Bombsurace/Tabletop-Stadium-Scoreboard/frame/stl/endzone_left_letters.step

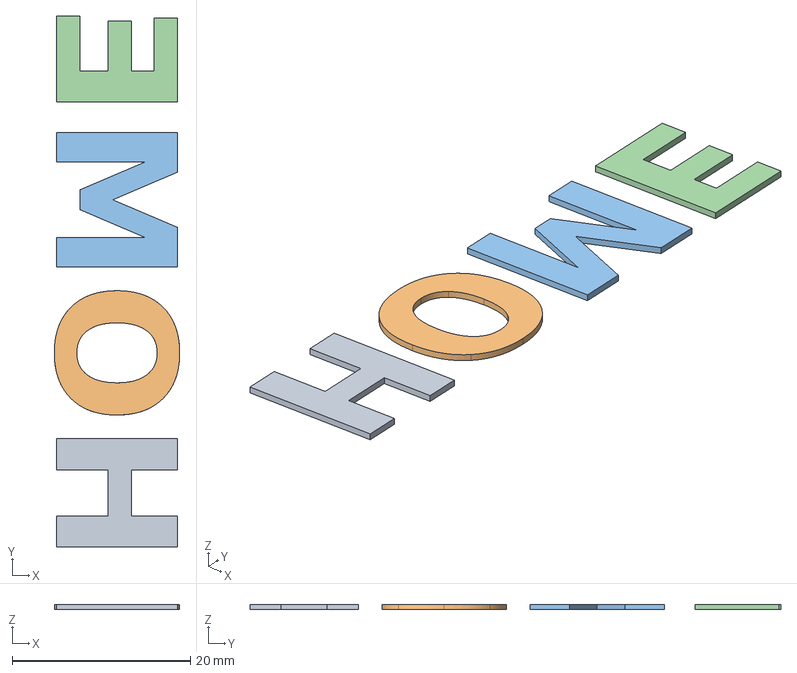
[picture p21: CAD file, 2026-11-06]
frame/stl/endzone_left_letters.step
14.1 x 59.5 x 0.6 mm
