Bombsurace/Tabletop-Stadium-Scoreboard/frame/stl/tests/kickstand_test_tight_catch.stl

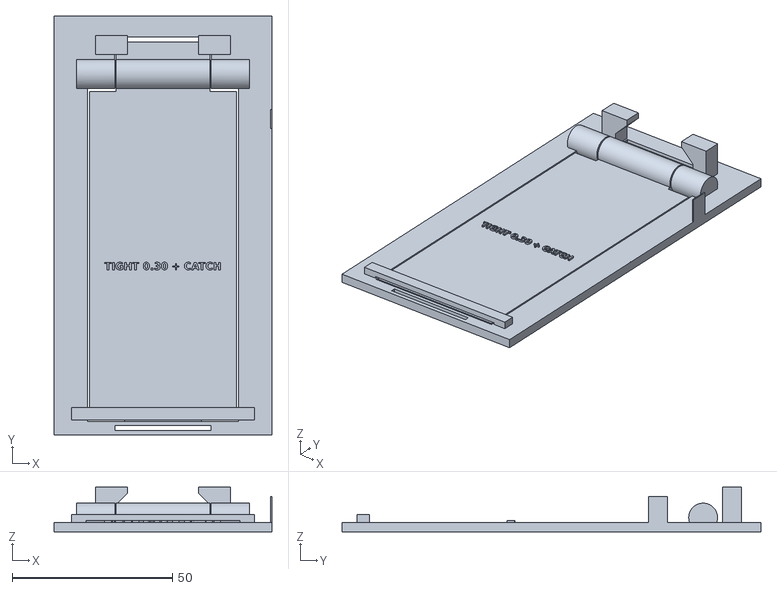
[picture p22: CAD file, 2026-11-05]
frame/stl/tests/kickstand_test_tight_catch.stl
68.0 x 130.6 x 14.0
