Bombsurace/Tabletop-Stadium-Scoreboard/frame/stl/endzone_left_2color.3mf

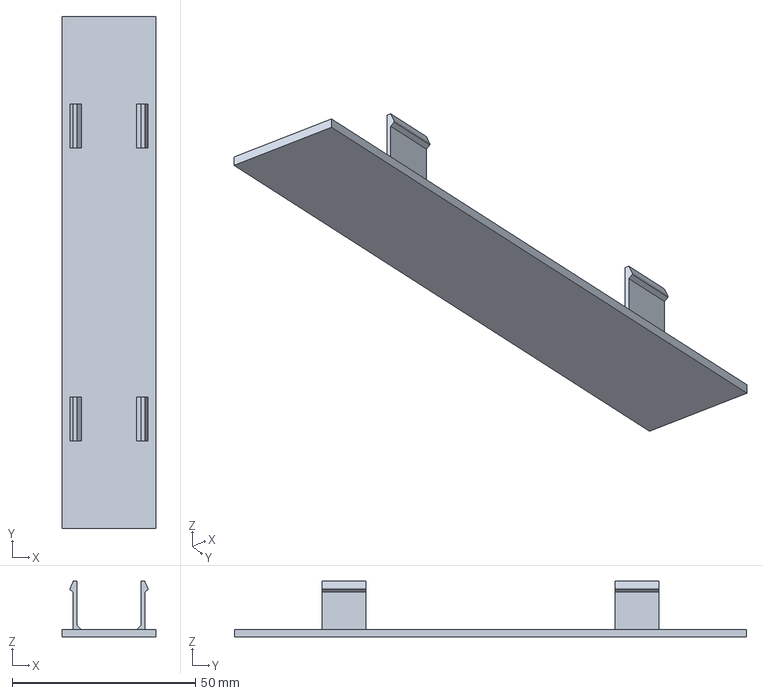
[picture p23: CAD file, 2026-11-06]
frame/stl/endzone_left_2color.3mf
25.6 x 139.6 x 15.2 mm
