Bombsurace/Tabletop-Stadium-Scoreboard/frame/stl/tests/hinge_test_tight.stl

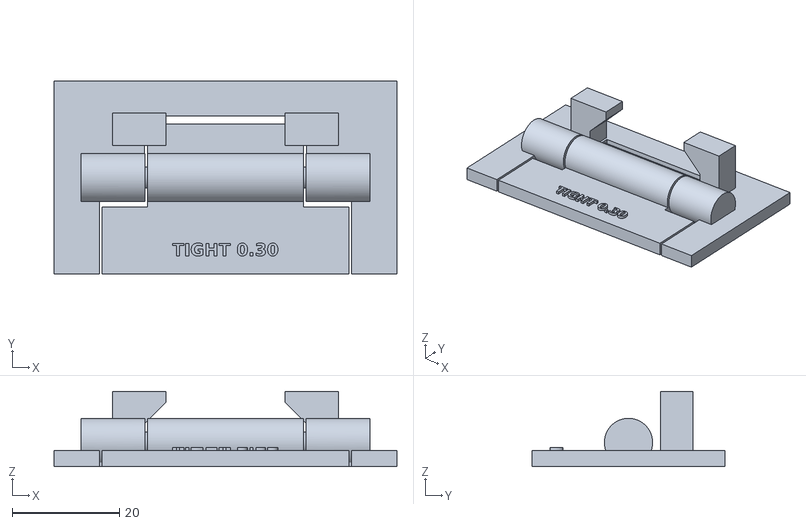
[picture p24: CAD file, 2026-11-05]
frame/stl/tests/hinge_test_tight.stl
64.0 x 36.0 x 14.0
