Bombsurace/Tabletop-Stadium-Scoreboard/frame/stl/endzone_right_letters.step

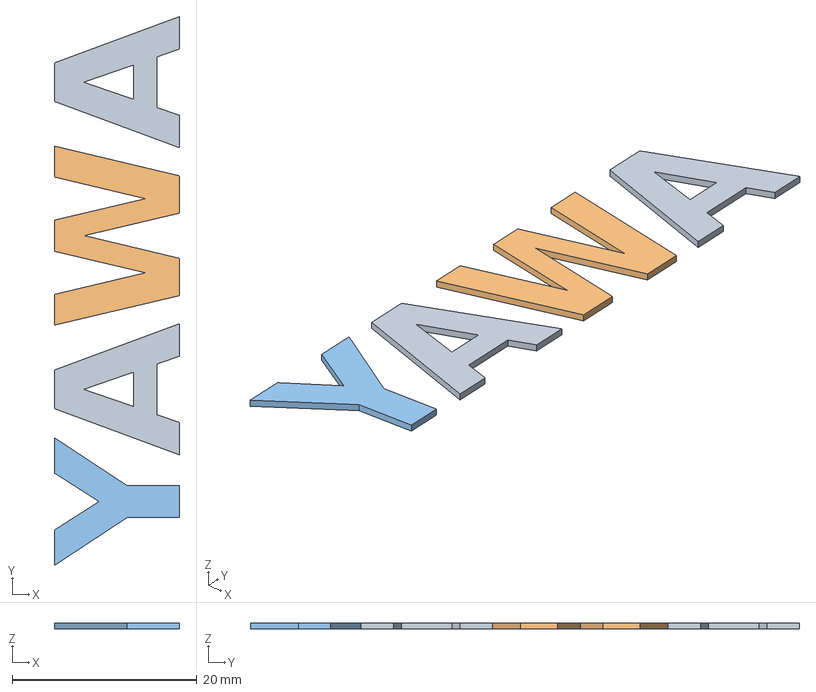
[picture p25: CAD file, 2026-11-06]
frame/stl/endzone_right_letters.step
13.6 x 59.4 x 0.6 mm
