Bombsurace/Tabletop-Stadium-Scoreboard/frame/stl/tests/screen_center_test_7in.stl

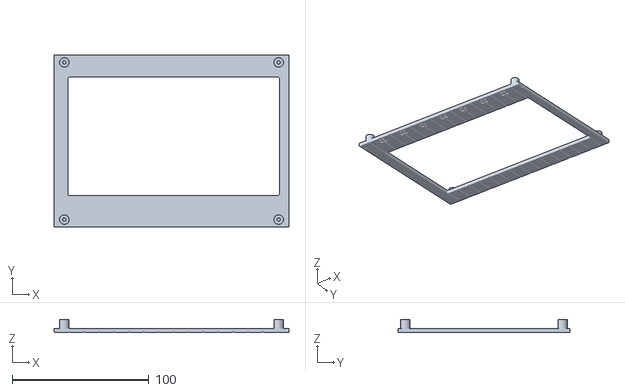
[picture p26: CAD file, 2026-11-05]
frame/stl/tests/screen_center_test_7in.stl
172.0 x 126.0 x 9.80
