Bombsurace/Tabletop-Stadium-Scoreboard/frame/stl/endzone_right.step

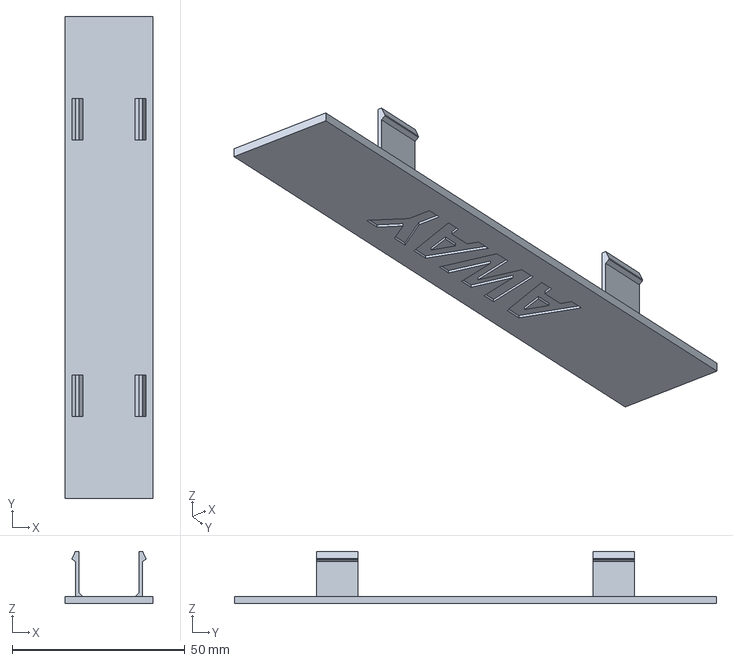
[picture p27: CAD file, 2026-11-06]
frame/stl/endzone_right.step
25.6 x 139.6 x 15.2 mm
