Bombsurace/Tabletop-Stadium-Scoreboard/frame/stl/tests/wall_fit_test_switch_usbc.stl

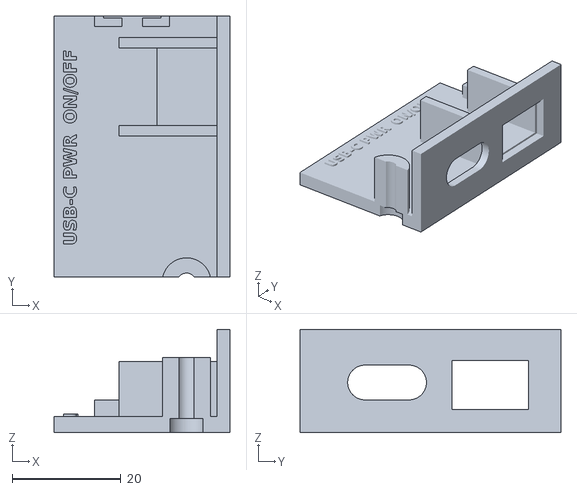
[picture p28: CAD file, 2026-11-05]
frame/stl/tests/wall_fit_test_switch_usbc.stl
32.4 x 48.0 x 19.0
