Bombsurace/Tabletop-Stadium-Scoreboard/frame/stl/tests/pi_antenna_fit_test.stl

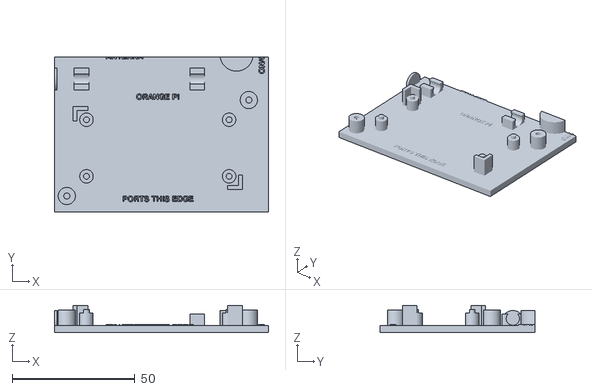
[picture p29: CAD file, 2026-11-05]
frame/stl/tests/pi_antenna_fit_test.stl
87.0 x 63.0 x 11.1
