Bombsurace/Tabletop-Stadium-Scoreboard/frame/stl/front_wide79_2color.3mf

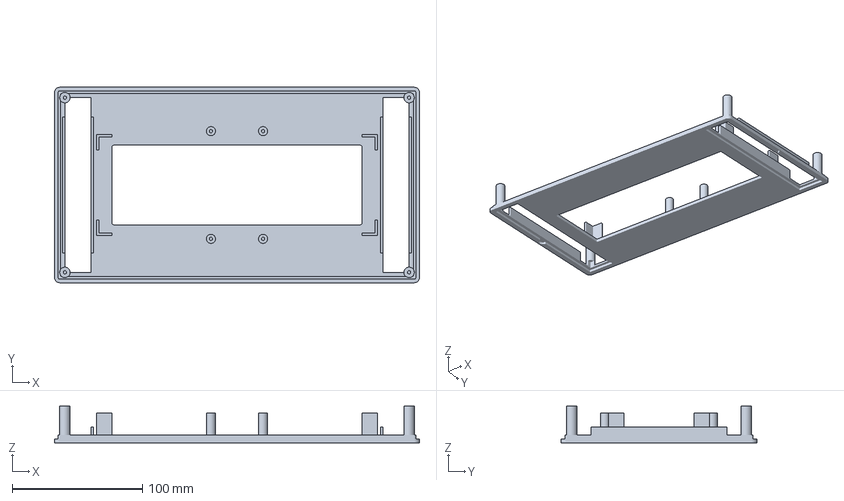
[picture p30: CAD file, 2026-11-05]
frame/stl/front_wide79_2color.3mf
280.0 x 150.0 x 28.0 mm
