Bombsurace/Tabletop-Stadium-Scoreboard/frame/stl/cutter_usb_c_socket.step

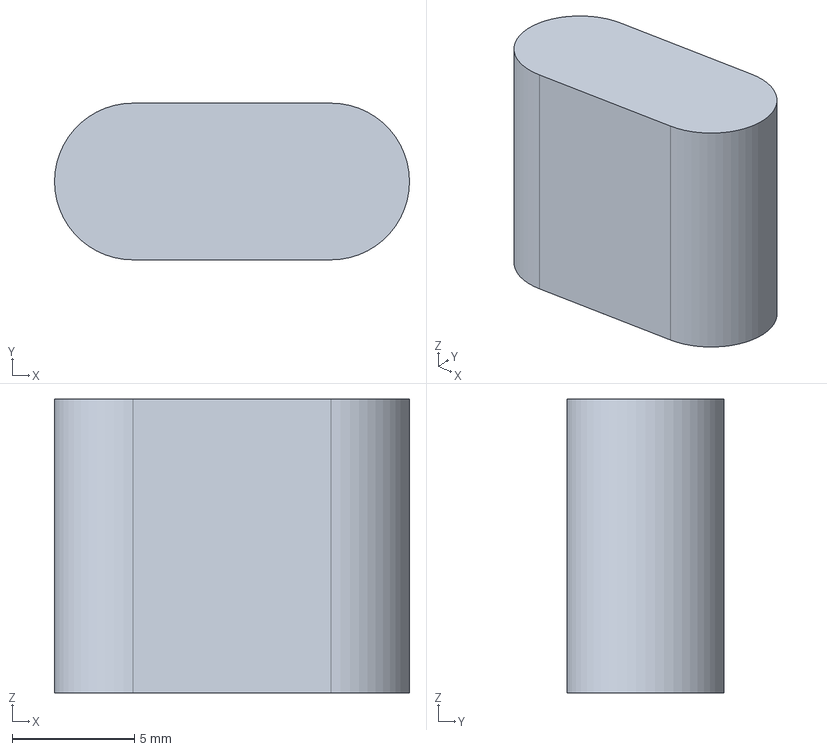
[picture p31: CAD file, 2026-11-05]
frame/stl/cutter_usb_c_socket.step
14.5 x 6.40 x 12.0 mm
