Bombsurace/Tabletop-Stadium-Scoreboard/frame/stl/back_tray_blank.step

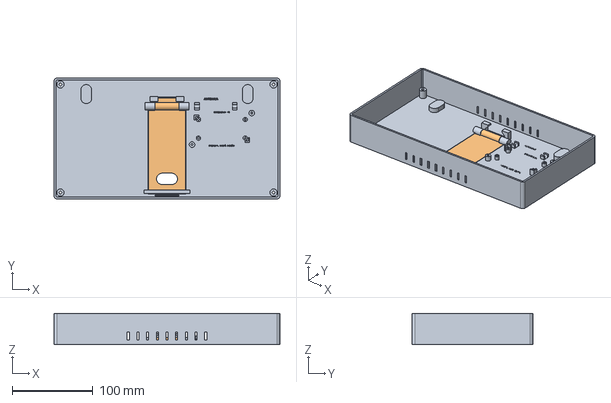
[picture p32: CAD file, 2026-11-05]
frame/stl/back_tray_blank.step
280.0 x 150.0 x 39.0 mm
