Bombsurace/Tabletop-Stadium-Scoreboard/frame/stl/endzone_blank.step

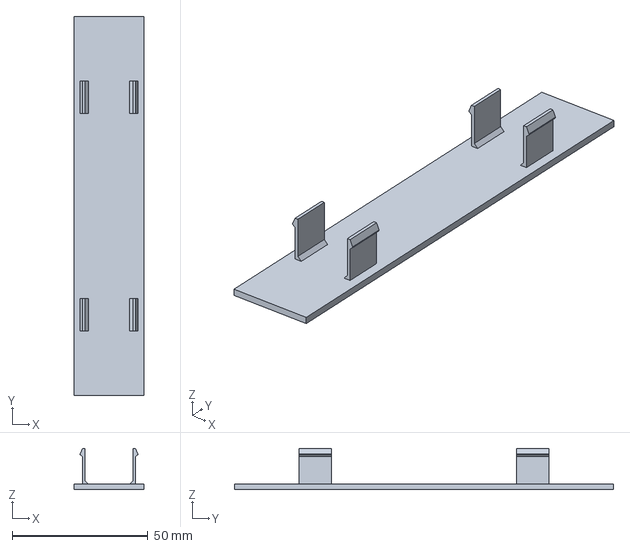
[picture p33: CAD file, 2026-11-05]
frame/stl/endzone_blank.step
25.6 x 139.6 x 15.2 mm
