Bombsurace/Tabletop-Stadium-Scoreboard/frame/stl/front_standard7_2color.3mf

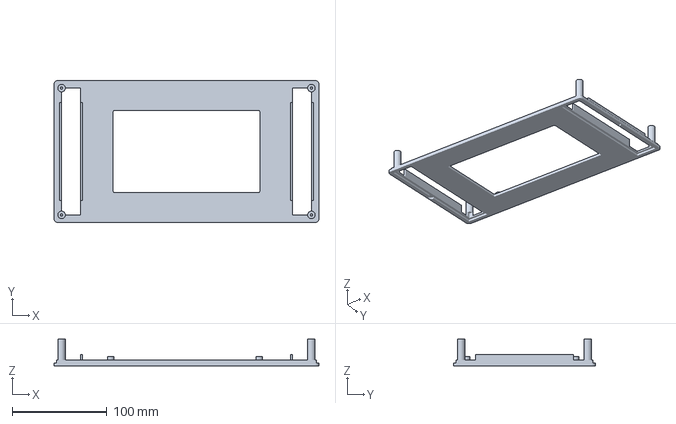
[picture p34: CAD file, 2026-11-05]
frame/stl/front_standard7_2color.3mf
280.0 x 150.0 x 28.0 mm
