Bombsurace/Tabletop-Stadium-Scoreboard/frame/stl/front_standard7.step

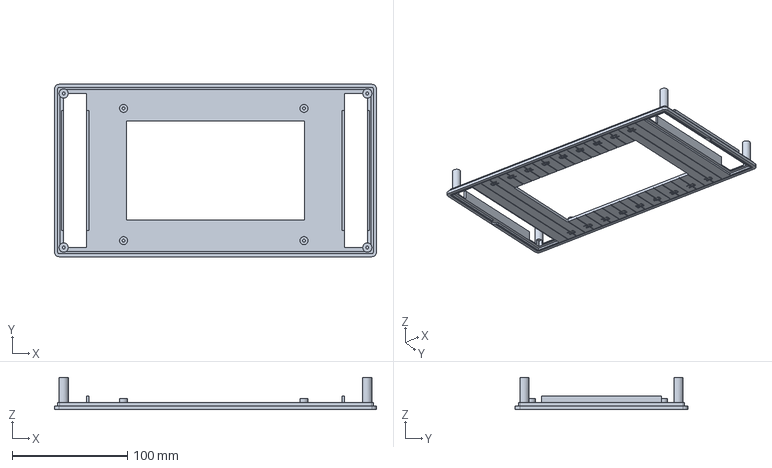
[picture p35: CAD file, 2026-11-05]
frame/stl/front_standard7.step
280.0 x 150.0 x 28.0 mm
