Bombsurace/Tabletop-Stadium-Scoreboard/frame/stl/front_standard7_lines.step

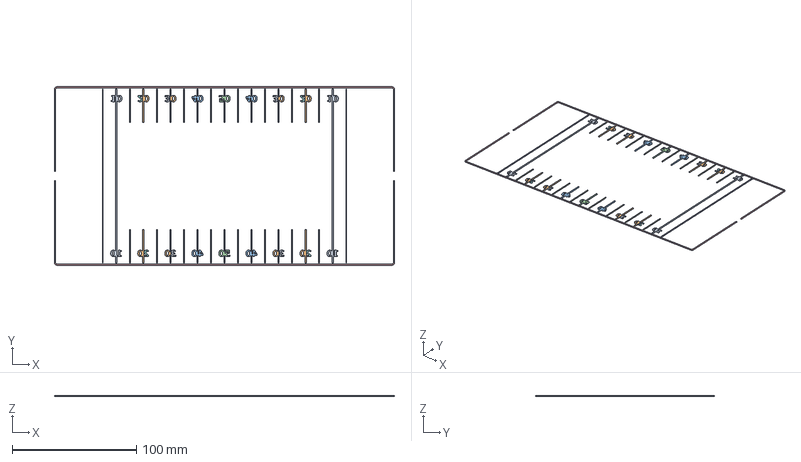
[picture p36: CAD file, 2026-11-05]
frame/stl/front_standard7_lines.step
274.0 x 144.0 x 0.6 mm
