Bombsurace/Tabletop-Stadium-Scoreboard/frame/stl/cutter_switch.step

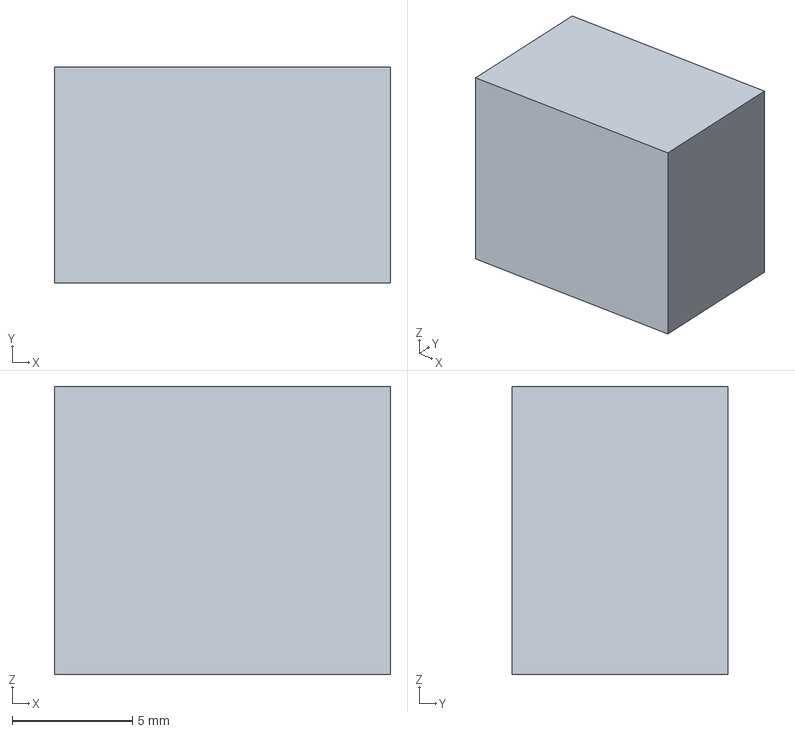
[picture p37: CAD file, 2026-11-05]
frame/stl/cutter_switch.step
14.0 x 9.00 x 12.0 mm
