Bombsurace/Tabletop-Stadium-Scoreboard/frame/stl/screen_tab.step

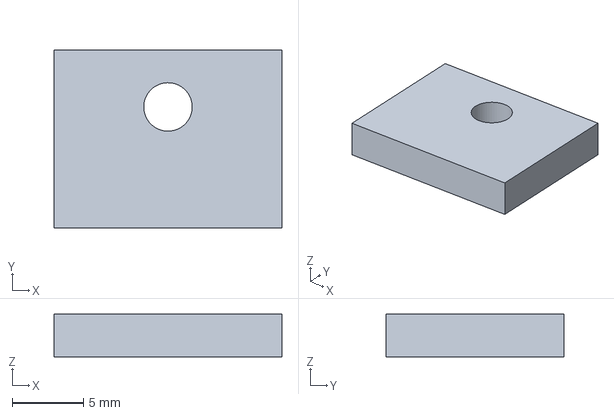
[picture p38: CAD file, 2026-11-05]
frame/stl/screen_tab.step
16.0 x 12.5 x 3.00 mm
