Bombsurace/Tabletop-Stadium-Scoreboard/frame/stl/pi_clamp.step

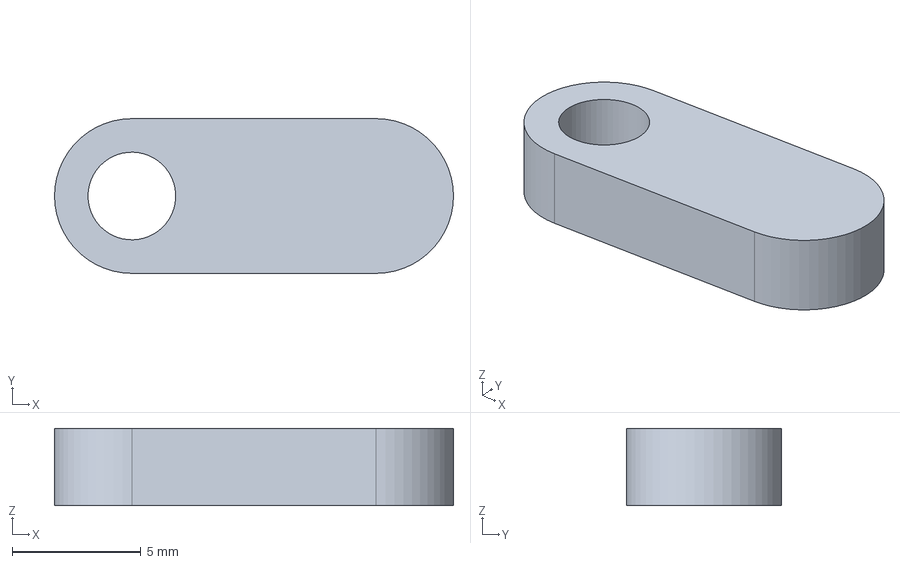
[picture p39: CAD file, 2026-11-05]
frame/stl/pi_clamp.step
15.5 x 6.00 x 3.00 mm
