Bombsurace/Tabletop-Stadium-Scoreboard/frame/stl/front_wide79_lines.step

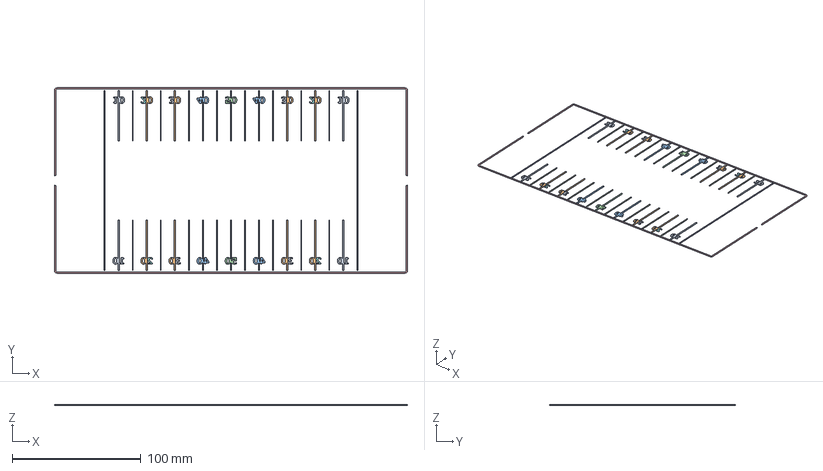
[picture p40: CAD file, 2026-11-05]
frame/stl/front_wide79_lines.step
274.0 x 144.0 x 0.6 mm
