Bombsurace/Tabletop-Stadium-Scoreboard/frame/stl/screen_cradle_wide79.step

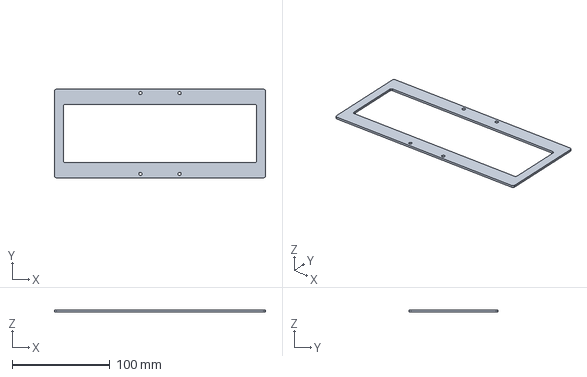
[picture p41: CAD file, 2026-11-05]
frame/stl/screen_cradle_wide79.step
215.6 x 90.6 x 2.00 mm
