Bombsurace/Tabletop-Stadium-Scoreboard/(list of files, cad)

Other CAD files:
frame/stl/endzone_right_2color.3mf
frame/stl/endzone_left.step
frame/stl/tests/hinge_test_loose.stl
frame/stl/tests/hinge_test_medium.stl
frame/stl/back_tray_loose.step
frame/stl/front_wide79.step
frame/stl/back_tray_medium.step
frame/stl/back_tray.step
frame/stl/back_tray.stl
frame/stl/back_tray_blank.stl
frame/stl/back_tray_loose.stl
frame/stl/back_tray_medium.stl
frame/stl/cutter_switch.stl
frame/stl/cutter_usb_c_socket.stl
frame/stl/endzone_blank.stl
frame/stl/endzone_left.stl
frame/stl/endzone_left_letters.stl
frame/stl/endzone_right.stl
frame/stl/endzone_right_letters.stl
frame/stl/front_standard7.stl
frame/stl/front_standard7_lines.stl
frame/stl/front_wide79.stl
frame/stl/front_wide79_lines.stl
frame/stl/pi_clamp.stl
frame/stl/screen_cradle_wide79.stl
frame/stl/screen_tab.stl
