Bombsurace/Tabletop-Stadium-Scoreboard/(commit log)

2026-11-05 First version: scoreboard software, field frame, docs
    Claude-Session: https://claude.ai/code/session_01P4ncuMYmzejqiMk9x7T5yz
    [back_customizer.scad, back_tray.step, back_tray.stl, back_tray_blank.step, back_tray_blank.stl, back_tray_loose.step, back_tray_loose.stl, back_tray_medium.step]
2026-11-06 Mockup renders, touchdown GIF, HOME/AWAY end zones, SD card size FAQ
    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
    [endzone_customizer.scad, endzone_left.step, endzone_left.stl, endzone_left_2color.3mf, endzone_left_letters.step, endzone_left_letters.stl, endzone_right.step, endzone_right.stl]
2026-11-07 Real build photos and GIFs; smoother touchdown and red zone animations
    The touchdown pulse animated a large blurred text-shadow every frame and the red zone
    animated an inset box-shadow on the whole board, so both repainted constantly on the
    Orange Pi. Both now animate only transform/opacity with the glow drawn once.
    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
2026-11-07 Docs: use the board's address for ssh, DietPi reboot quirk, copying a file to the board
    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
2026-11-08 Release workflow: also attach files when a release is published on the website
    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
2026-11-09 Warn clearly: power needs a USB-A charger and an A-to-C cable
    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
2026-11-09 Parts list: link for the USB-A charger
    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
2026-11-09 Point to the MakerWorld print files; mark OpenSCAD customizers as beta; list printers that fit
    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
