Bombsurace/Tabletop-Stadium-Scoreboard/(notices)

Notices in the files:
README.md:
License: MIT
Models: CC BY-NC-SA 4.0
